mohammedabdelsaboor/BI-Copter-Flight-controller/docs/media/bicopter_in_hand.jpg

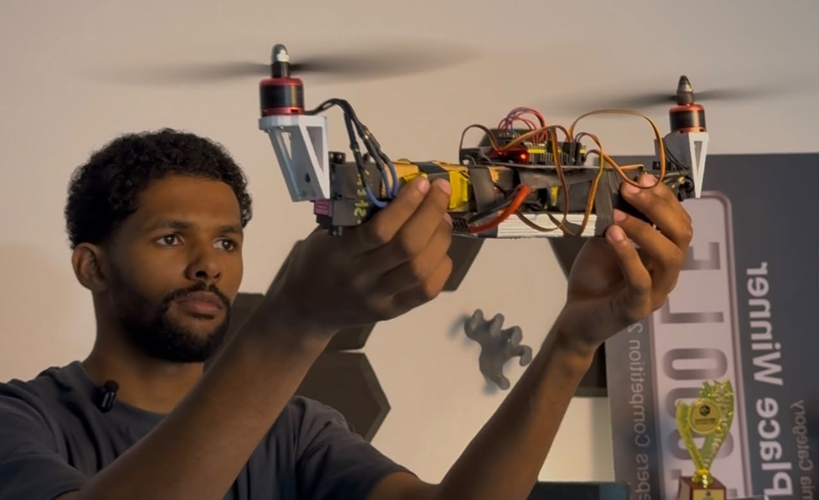
docs/media/bicopter_in_hand.jpg
