mohammedabdelsaboor/BI-Copter-Flight-controller/hardware/3d-parts/brushless-motor-mount/README.txt

Brushless Motor Mount by protorobotics on Thingiverse: https://www.thingiverse.com/thing:4009542

Summary:
Designed in Tinkercad, these motor mounts were designed for use in DIY foamboard RC planes. Secured via hot glued on the bottom of the print as well as to the side of the foamboard fuselage with BBQ skewers.
