mohammedabdelsaboor/BI-Copter-Flight-controller/hardware/3d-parts/servo-mount/README.txt

servo mount holder flange mounting feet by sternli27 on Thingiverse: https://www.thingiverse.com/thing:1477838

Summary:
I changed a few thingsHoles in the ground, rather than on the sideSome radii in the corners and cable holesshoud work with any medium rc servo
