mohammedabdelsaboor/BI-Copter-Flight-controller/hardware/3d-parts/brushless-motor-mount/images/20191129_131836.jpg

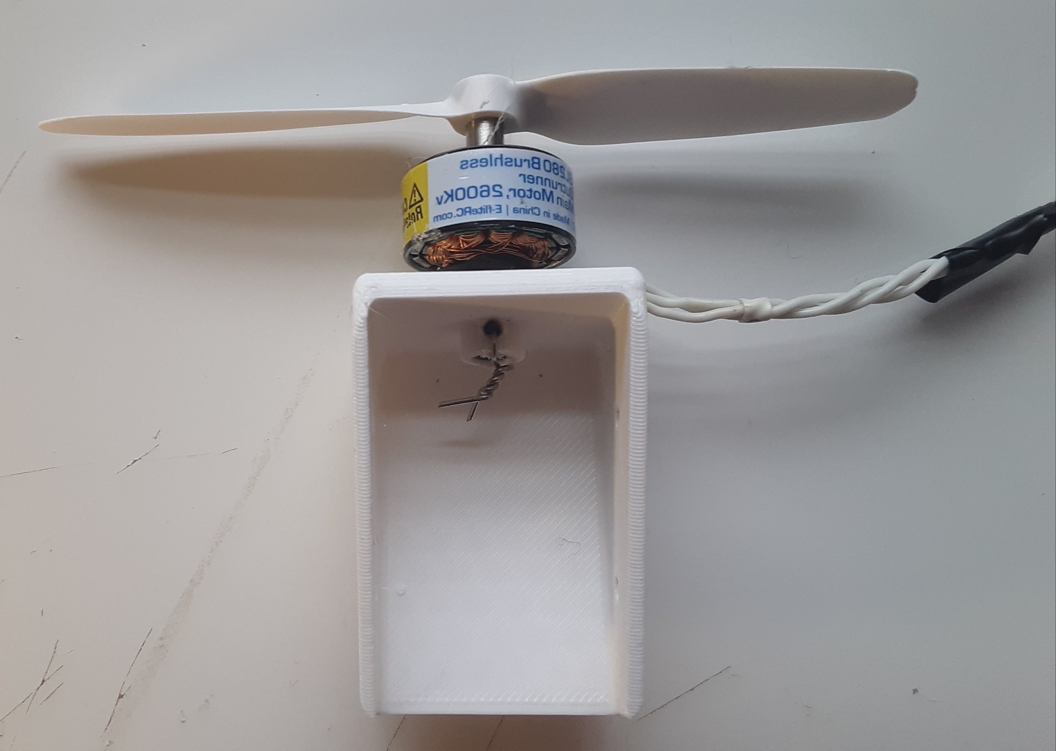
hardware/3d-parts/brushless-motor-mount/images/20191129_131836.jpg
