mohammedabdelsaboor/BI-Copter-Flight-controller/hardware/3d-parts/brushless-motor-mount/images/brushless_motor_mount.png

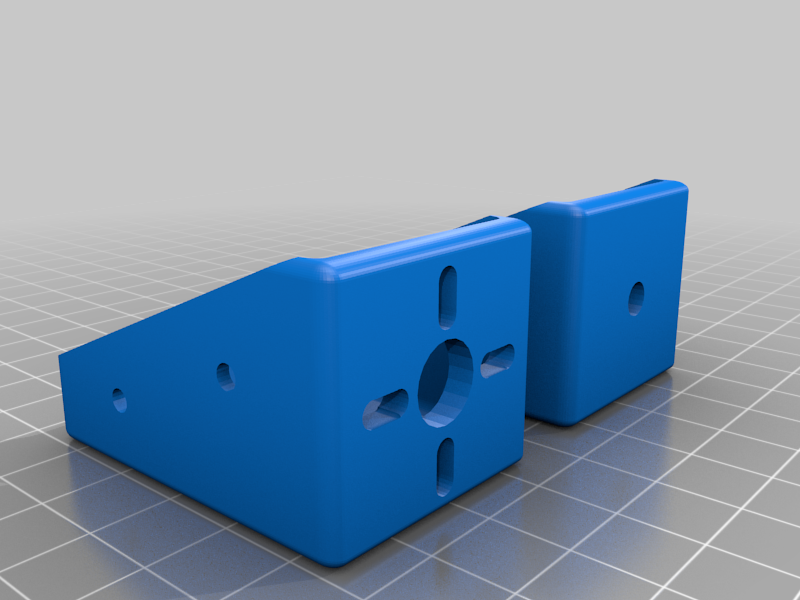
hardware/3d-parts/brushless-motor-mount/images/brushless_motor_mount.png
