mohammedabdelsaboor/BI-Copter-Flight-controller/hardware/3d-parts/servo-mount/images/c3d2c2c0e8741ae61d52498ee01e1cae.png

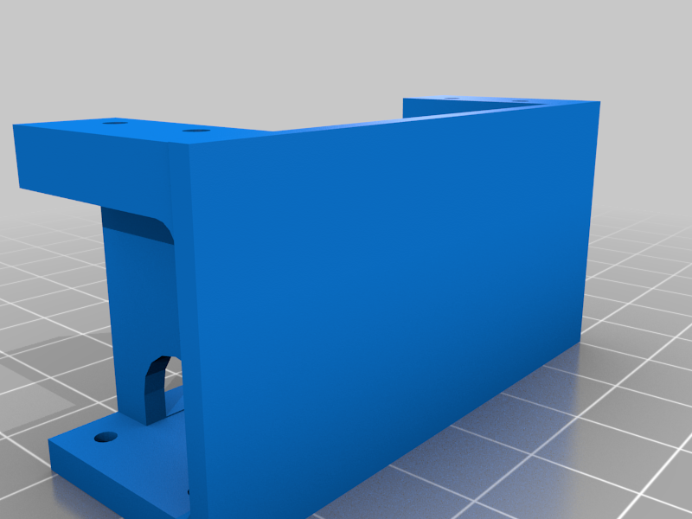
hardware/3d-parts/servo-mount/images/c3d2c2c0e8741ae61d52498ee01e1cae.png
