mohammedabdelsaboor/BI-Copter-Flight-controller/hardware/3d-parts/servo-mount/images/pic1.jpg

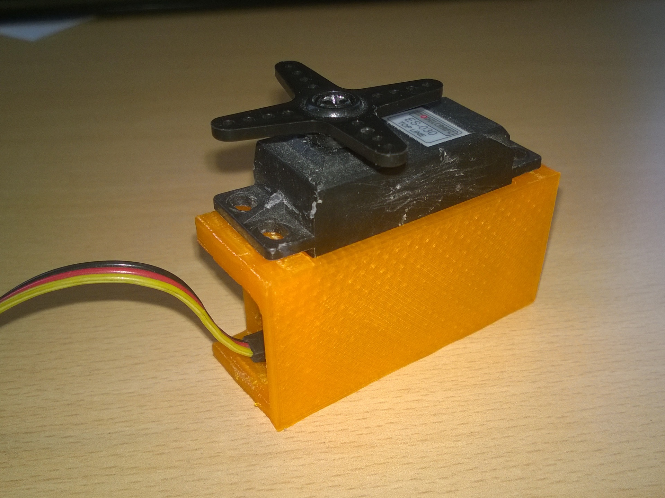
hardware/3d-parts/servo-mount/images/pic1.jpg
