mohammedabdelsaboor/BI-Copter-Flight-controller/hardware/3d-parts/servo-mount/images/pic2.jpg

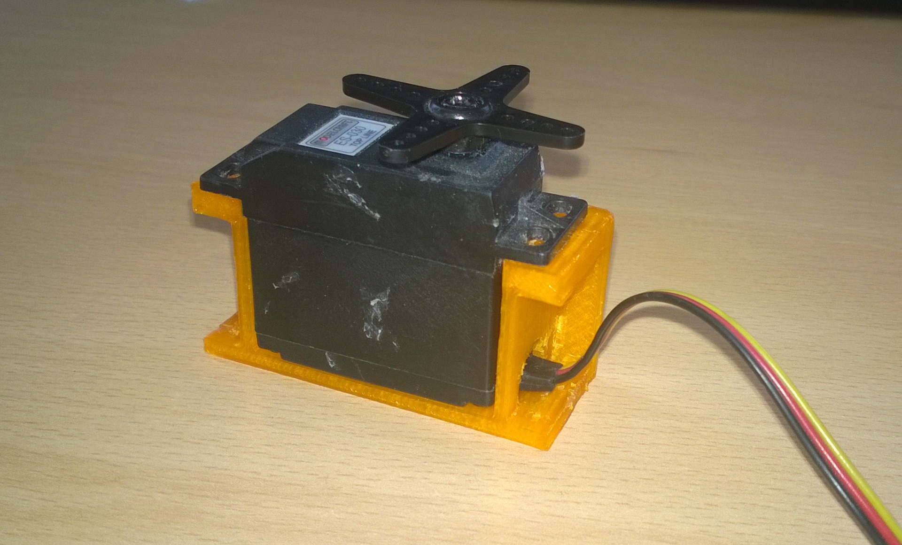
hardware/3d-parts/servo-mount/images/pic2.jpg
