mohammedabdelsaboor/BI-Copter-Flight-controller/hardware/3d-parts/servo-mount/images/pic3.jpg

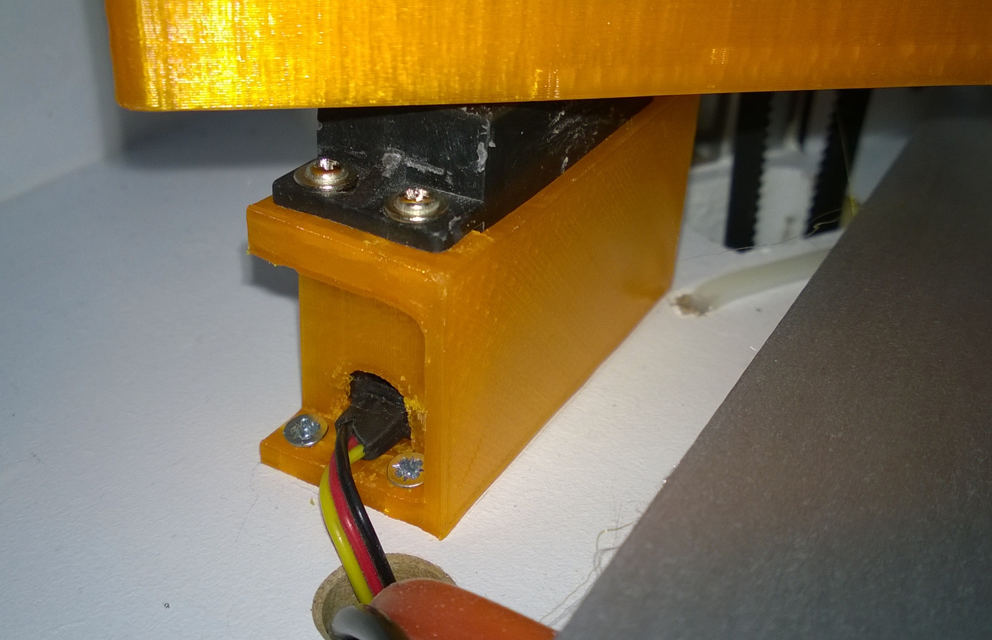
hardware/3d-parts/servo-mount/images/pic3.jpg
