mohammedabdelsaboor/BI-Copter-Flight-controller/hardware/3d-parts/brushless-motor-mount/files/brushless_motor_mount.stl

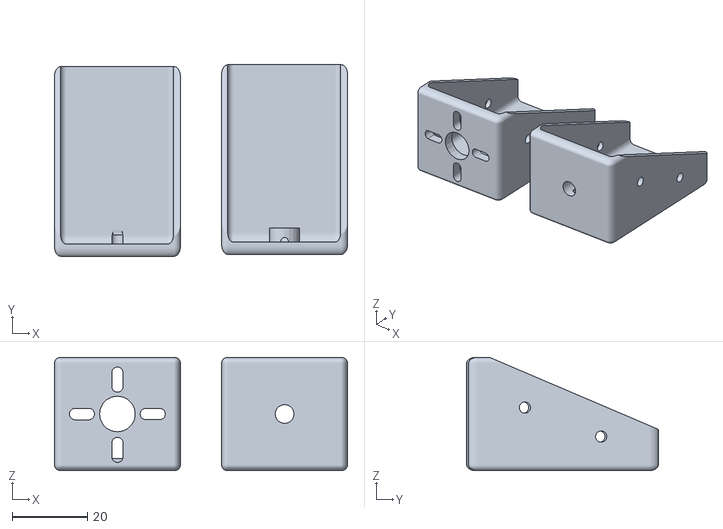
[picture p24: CAD file, 2026-10-27]
hardware/3d-parts/brushless-motor-mount/files/brushless_motor_mount.stl
78.0 x 51.0 x 30.2
