mohammedabdelsaboor/BI-Copter-Flight-controller/hardware/3d-parts/servo-mount/files/servo-mount.step

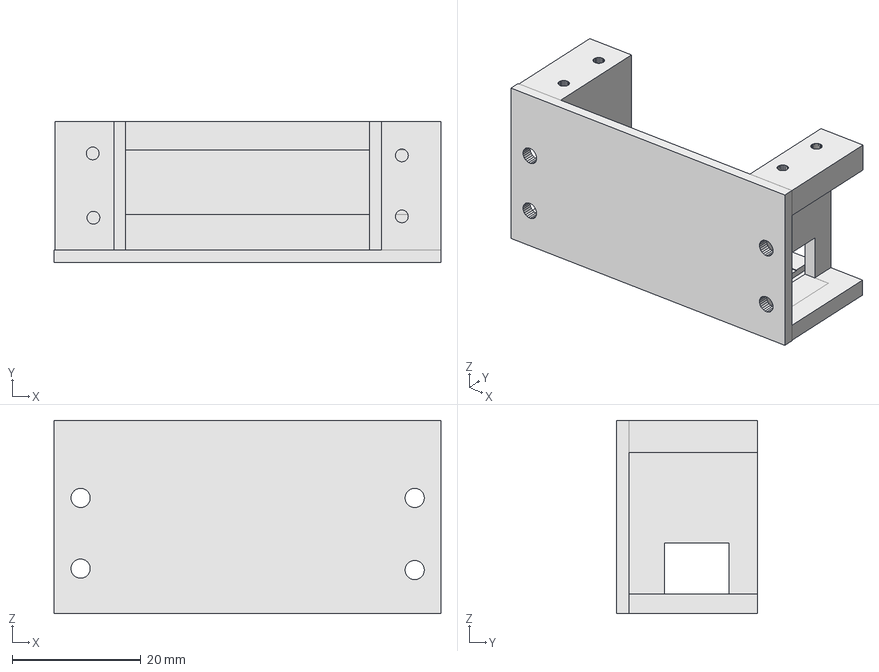
[picture p25: CAD file, 2026-10-27]
hardware/3d-parts/servo-mount/files/servo-mount.step
60.2 x 22.0 x 30.1 mm
