mohammedabdelsaboor/BI-Copter-Flight-controller/(list of files, cad)

Other CAD files:
hardware/3d-parts/servo-mount/files/servo-mount.stl
