mohammedabdelsaboor/BI-Copter-Flight-controller/docs/media/bicopter_flight_test.jpg

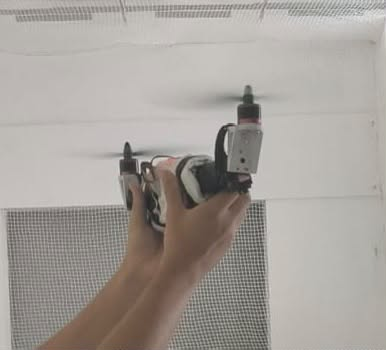
docs/media/bicopter_flight_test.jpg
