mohammedabdelsaboor/BI-Copter-Flight-controller/docs/media/last_test_photo.jpg

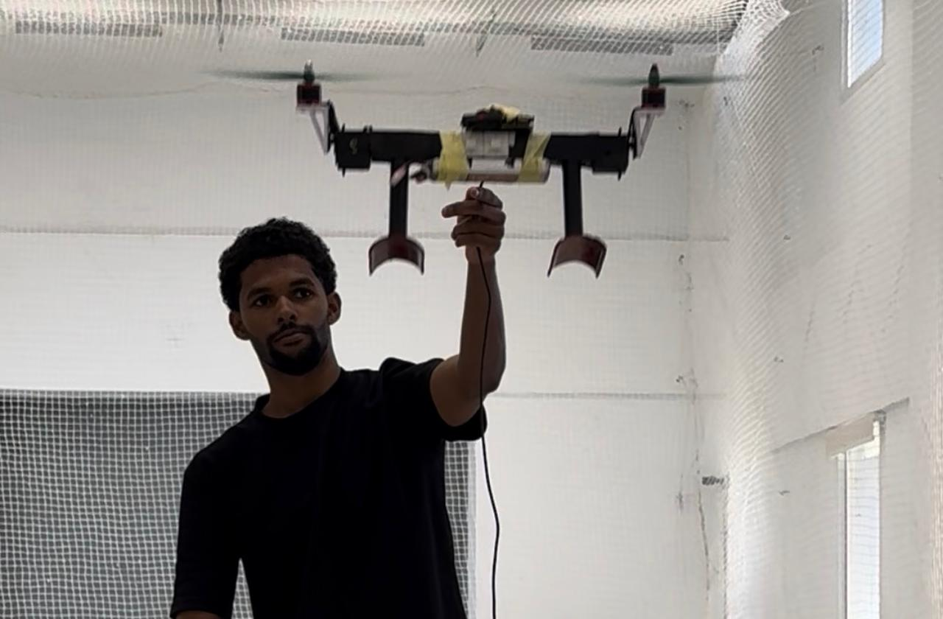
docs/media/last_test_photo.jpg
