mohammedabdelsaboor/BI-Copter-Flight-controller/(commit log)

2026-10-23 Add web tuning page, hover balance, flight recorder and yaw fix
    - WiFi access point with a tuning page at http://192.168.4.1: live attitude,
    level calibration, servo trims with live motor tilt, PID gains, save to flash
    - Flight recorder on the page: 25 Hz samples downloaded as a .csv
    - Hover balance: learn the motor tilt held in hover and pitch the body the
    other way so the thrust stays vertical; saved to flash after each flight
    - Yaw stick: fixed 1500 us centre and 75 us deadband (throttle/yaw gimbal
    crosstalk on the FS-i6 was read as a yaw command)
    - Servo directions and yaw correction set for this model
    - README: photo of the model, test flight video, web tuning section
    [Config.hpp, bi_copter_firmware.ino]
2026-10-24 Port ArduPilot bicopter features, fix pitch saturation, add drift trim
    - Thrust linearisation of the ESC outputs (ArduPilot MOT_THST_EXPO 0.65)
    - Servo (pitch/yaw) commands scaled by hover throttle / throttle, boost only
    - Accelerometer trusted more slowly (tau 0.8 -> 3 s): on a bicopter it sees the
    thrust direction, which tilts with the servos
    - Pitch I limit 0.25 -> 0.50 and output limit 0.60 -> 0.70: logged throttle
    sweeps showed the I term saturating while the model hung 20-25 deg nose-up
    - Less delay in the pitch loop: servo command filter 10 -> 20 Hz, pitch gyro
    filter 25 -> 40 Hz
    - Hover balance: learned only in steady hover, limited to 6 deg, reset button
    and 'hover reset' co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
    [Config.hpp, bi_copter_firmware.ino]
2026-10-27 Simpler pitch control, Mahony attitude filter, take-off detection, docs update
    Flight control
    - Take-off detection: I terms, heading hold, roll on the motors and hover
    learning only switch on at LIFTOFF_THROTTLE, so nothing winds up against
    the ground (the model used to shoot forward at lift-off)
    - Pitch/yaw back to a plain PID baseline: servo lead, slew limiter,
    square-root angle controller and throttle gain scaling switched off
    - Servo tilt range +-40 deg, servos at 100 Hz, crash cut-out at 60 deg
    - Stale hover feed-forward disabled
    Sensors
    - AttitudeEstimator is now a Mahony filter with gyro bias learning,
    smooth accelerometer trust and a 10 Hz accelerometer low pass
    - New Biquad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
    [Config.hpp, bi_copter_firmware.ino]
2026-10-27 Restructure the README as a project report and the docs as appendices
    - README: abstract, introduction, system description, control design with
    equations, implementation, experimental results from the logged tests,
    discussion, future work, references and a BibTeX entry
    - docs/WIRING.md and docs/SETUP_AND_TUNING.md become Appendix A and B with
    numbered sections
    - CITATION.cff for GitHub's "Cite this repository"
    - Corrected the crash cut-out angle (60 deg)
2026-10-27 Add result figures to the README and the PDF guide
    - Figure 1 (measured): roll vs pitch angle and pitch command from a logged
    throttle sweep; the log is kept in docs/data/ so the figure can be rebuilt
    - Figure 2 (simulated): pitch estimation error, complementary vs Mahony
    filter; tools/sim/attitude_sim.cpp runs the firmware's own estimator
    - Figure 3 (simulated): servo step response with and without phase lead
    - tools/make_figures.py regenerates all three
    - README results section rewritten around the figures; the PDF gets a
    "Test results" section with them (Figures 4-6)
    [make_figures.py]
2026-10-27 Add the 3D-printed motor and servo mounts
    - hardware/3d-parts/brushless-motor-mount: STL, by protorobotics (Thingiverse
    thing:4009542, CC BY-SA)
    - hardware/3d-parts/servo-mount: STL and STEP, by sternli27 (Thingiverse
    thing:1477838, CC BY)
    - hardware/README.md credits both authors; original licence files kept
    - README links to the hardware folder
    [brushless_motor_mount.stl, servo-mount.step, servo-mount.stl]
2026-10-27 Add the recorded flight data and academic-style result figures
    - docs/data/bicopter_20261023_182347.csv: flight record from the web page
    recorder (22 s, 25 Hz, 23 channels)
    - tools/make_figures.py: all figures redrawn in a plain academic style
    (serif text, panel labels, units on every axis, 300 dpi) and four new
    figures from the recorded flight: attitude, rate tracking, actuator
    outputs and RMS tracking error per axis
    - PDF guide: "Recorded flight" subsection with a statistics table and
    Figures 7-10
    - README: recorded-flight results with the statistics table and two figures
    [bicopter_20261023_182347.csv]
2026-10-27 Add rendered images of the tilt mechanism parts
    - tools/render_parts.py renders the motor mount and servo mount from their
    STL files (docs/figures/fig8_mechanism_parts.png)
    - Shown as Figure 2 in the PDF guide and Figure 1 in the README; the later
    figures are renumbered
    - hardware/README.md shows the render above the parts table
2026-10-27 Use photos of the tilt mechanism parts instead of the STL render
    - Figure 2 (PDF) / Figure 1 (README): 2 x 2 grid of the designers' photos of
    the motor mount and servo mount in use, credited in the caption
    - Built by tools/make_figures.py from hardware/3d-parts/*/images, saved as JPEG
    - Removed the STL render and tools/render_parts.py
2026-10-27 Show the real bicopter instead of the parts' catalogue photos
    - Figure 2 (PDF) / Figure 1 (README) now shows the model built in this
    project: the complete model, close-ups of both tilt units, and the model
    running in hand
    - Built from docs/media/bicopter.jpg and two frames of the hand-held test
    video (docs/media/handheld_test_*.jpg), cropped without stretching
    - Captions and hardware/README.md updated
2026-10-28 Restructure the PDF as an academic project report
    - docs/BiCopter_Report.pdf replaces the project guide: title page, abstract
    with keywords, contents, lists of figures and tables, numbered chapters
    (introduction, related work, system, modelling and control design,
    implementation, experimental results, discussion, conclusions), numbered
    equations, references and appendices (wiring, setup and tuning, console,
    problems encountered)
    - Booktabs tables with captions above, figure captions below, automatic
    figure and table numbering, roman page numbers for the front matter
    - tools/make_report.py replaces tools/make_guide.py
    - Corrected the crash cut-out angle in the safety table (60 deg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
    [make_figures.py, make_report.py]
2026-10-28 Reframe the bicopter photo figure around the aircraft
    - Every panel is cropped around the aircraft or its tilt unit and centred
    - (d) now uses the sharp hand-held photo, (e) the flight-test photo; the
    low-resolution video frames are removed
    - docs/media/bicopter_flight_test.jpg (was docs/figures/fly.jpeg)
    - Captions updated in the README and the report; report rebuilt
2026-11-04 Add the two-board serial version of the bicopter firmware
    bi_serial_comunication/ is a self-contained copy of the flight firmware for an
    ESP32-S3 SuperMini. The FS-iA6B receiver is read by an ESP32-S3 PowerFeather,
    which sends the four channels to the flight controller over UART in a 13-byte
    frame with a sequence number and CRC-8, 100 times a second.
    - esp32s3_supermini: flight controller. Servos on GPIO3/4, ESCs on GPIO5/6,
    MPU6050 on GPIO8/9, link input on GPIO43. SerialRcInput replaces RcPwmInput
    and fails safe when frames stop or the bridge reports the receiver lost.
    The web page shows the four channels and the link counters.
    - powerfeather_rc_bridge: measures CH1-CH4 on GPIO36-39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
    [Config.hpp]
2026-11-04 Revert the serial branch merge on main
    main keeps the original single-board PowerFeather project. The two-board
    SuperMini + PowerFeather version (bi_serial_comunication/) and its README stay
    on the Serial_comunication_BI_copter branch.
    This reverts merge commit c1d5785.
    [Config.hpp]
2026-11-04 Add a documents overview and the four-link arm results to the README
    - A Documents table near the top links the report, the expected-results PDF
    for the four-link arm, the wiring and setup guides, the 3D parts and the
    flight data, and points to the serial branch for the two-board build.
    - New section 7 summarises the simulated four-link flying arm with two
    figures; Future work and Reproducing move to sections 8 and 9.
    - Adds the expected-results PDF and its two figures to docs/, and the DRAGON
    and SPIDAR papers to the references.
2026-11-04 Remove the four-link arm and the future work
    The README no longer has the four-link arm section, its PDF and figures, the
    DRAGON and SPIDAR references or the future-work list; Reproducing becomes
    section 7. The report's last chapter is now Conclusions only.
    [make_report.py]
2026-11-11 Put the latest test photo in the header and fix the video text
    The header now shows three photos: the model on its stand, held by hand, and
    hovering in the netted flight area during the latest test. The separate photo
    in section 5.1 is gone, and the text no longer calls the ESP32-S3 power cable
    a tether.
